manovirajsharma/esp32-water-level-monitor/(commit log)

2026-09-18 Revise README for ESP32 Water Level Monitoring System
    Expanded project description and added detailed components, circuit overview, build process, and setup instructions.
2026-09-18 Add sensor closeup image to README
    Added image of sensor closeup to the circuit overview section.
2026-09-18 Fix image path for sensor closeup
    Updated image path for sensor closeup in README.
