manovirajsharma/esp32-water-level-monitor/IMG_3347.jpeg

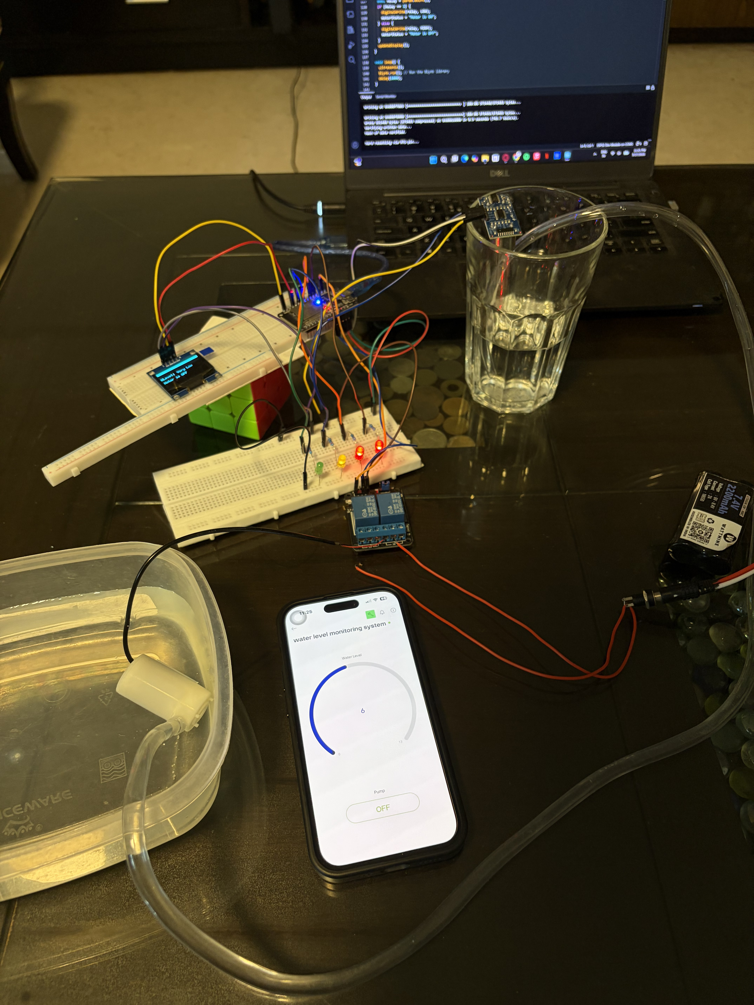
[picture p1: images/main.jpeg]
IMG_3347.jpeg
