manovirajsharma/esp32-water-level-monitor/IMG_7323.jpeg

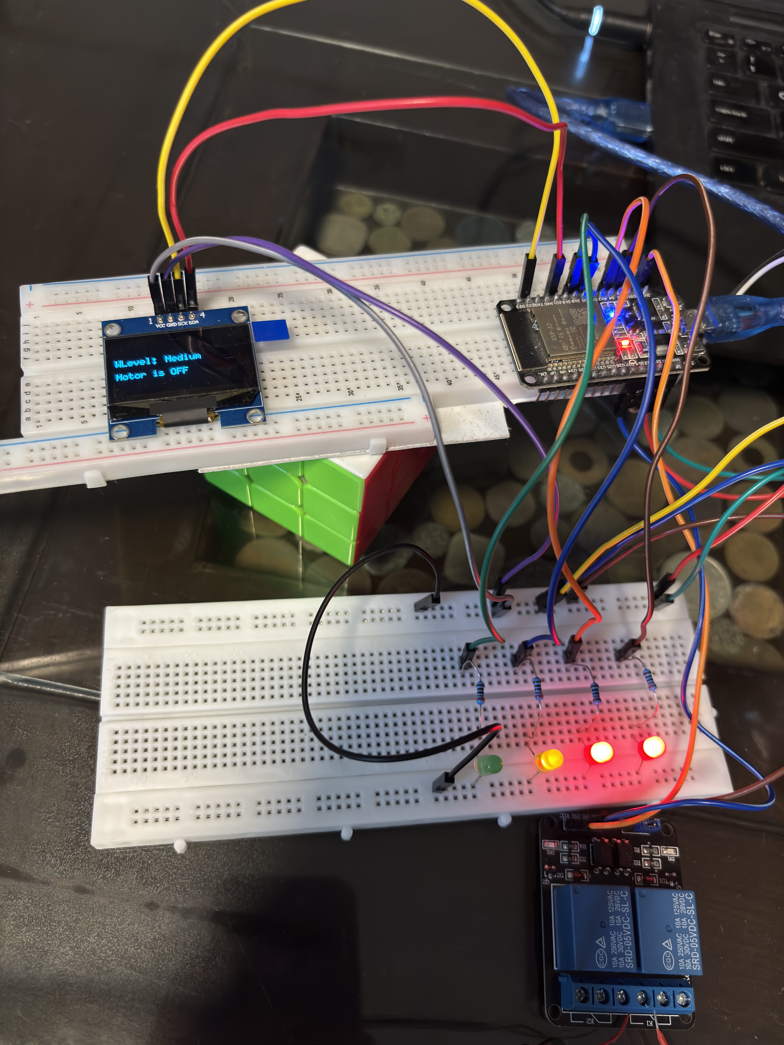
[picture p2: images/medium_level.jpeg]
IMG_7323.jpeg
