manovirajsharma/esp32-water-level-monitor/IMG_7324.jpeg

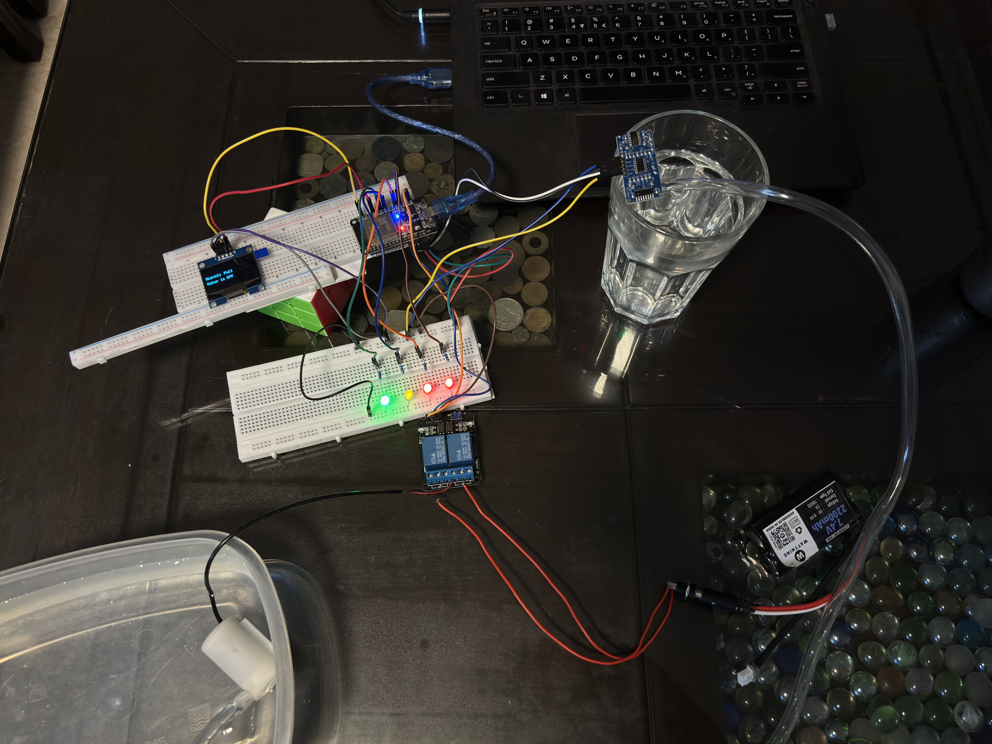
[picture p3: images/full_setup.jpeg]
IMG_7324.jpeg
